lu7did/PixiePico/README.md

# PixiePico
Pixie kit based FT8 transceiver

Project documentation is held at the following [Jupyter notebook file](https://github.com/lu7did/PixiePico/blob/main/doc/PixiePico.ipynb)
