lu7did/PixiePico/doc/PixiePico_API.docx

Generé el proyecto completo testDDS, derivado de testGUI y listo para importar en Visual Studio Code:

Descargar

Incluye:

- src/main.c: integración OLED, encoder, WS2812, USB CDC y DDS.
- src/dds.c y src/dds.h: API, solver exhaustivo, control PLL, DMA y reinicio.
- src/dds_square.pio: generador cuadrado con modulación Bresenham.
- CMakeLists.txt actualizado.
- Configuración .vscode.
- README.md con instrucciones y restricciones.
- tools/verify_solver.py para reproducir los cálculos en una PC.

API implementada:

bool dds_init(dds_t *dds, const dds_config_t *config);

bool dds_solve(const dds_t *dds,

uint32_t target_hz,

dds_solution_t *solution);

bool dds_start(dds_t *dds,

const dds_solution_t *solution);

void dds_stop(dds_t *dds);

dds_setfreq_result_t dds_setfreq(

dds_t *dds,

uint32_t target_hz,

dds_solution_t *solution_out);

Características principales:

- Rango configurable mediante DDS_SYS_CLK_MIN_HZ y DDS_SYS_CLK_MAX_HZ.
- Valores predeterminados: 125–250 MHz.
- Salida predeterminada: GPIO14.
- DDS ubicado en PIO1 para no interferir con el WS2812 de PIO0/SM0.
- State machine y canal DMA reclamados dinámicamente.
- Divisor PIO completo en formato 16.8.
- Patrón Bresenham de 1024 semiperíodos.
- DMA circular de 8192 bytes.
- Solver sin umbral mínimo: siempre devuelve la mejor solución representable, salvo frecuencia cero o fuera del rango físico.
- PLL aplicado antes de stdio_init_all().
- Si dds_setfreq() necesita otro PLL con USB funcionando, guarda la frecuencia y ejecuta un reinicio por watchdog.
- Los scratch registers 6 y 7 evitan interferir con el registro 4 reservado por el SDK.

Resultados reproducidos:

Objetivo | PLL_SYS | CLKDIV PIO | Patrón | Error medio
7.074.000 Hz | 166,5 MHz | 4 + 4/256 | 953/1024 | −0,023339 Hz
14.074.000 Hz | 134 MHz | 2 + 38/256 | 221/1024 | −0,240394 Hz
28.074.000 Hz | 160,5 MHz | 1 + 101/256 | 51/1024 | +0,824722 Hz

El SDK confirma que el divisor PIO tiene formato 16.8 y que check_sys_clock_hz() valida si un reloj es realmente alcanzable; el proyecto usa ambas interfaces directamente. Documentación oficial del Pico SDK (https://www.raspberrypi.com/documentation/pico-sdk/hardware.html)

No pude efectuar la compilación ARM completa porque este entorno no contiene Pico SDK ni pioasm. Sí verifiqué la estructura del proyecto, la integridad del ZIP, las firmas relevantes del SDK y los resultados matemáticos del solver.

Recomendación concreta: importar ahora testDDS en la extensión Raspberry Pi Pico, compilar sin modificar nada y comprobar primero que se genere testDDS.uf2. Después, medir GPIO14 inicialmente a 28,074 MHz y verificar simultáneamente estabilidad USB, frecuencia media y espectro.
