lu7did/PixiePico/doc/Nota Tecnica PLL_PIO_VCO/Nota_Tecnica_Optimizacion_PLL_PIO_RP2040.pdf

## Implementación de VCO usando RP2040

Dr. Pedro E. Colla (LU7DZ) pedro.colla@gmail.com

Proyecto: PixiePico

4 de septiembre de 2026

Resumen

Esta nota técnica documenta el desarrollo de un algoritmo para implementar un VCO (DDS) basado en la utilización de un procesador ARM rp2040 tal como el disponible en placas rp2040 Zero o Raspberry Pico. El VCO utiliza un PIO entre los 8 disponibles en la arquitectura para generar una onda cuadrada a partir del control del clock de ejecución y los divisores disponibles. Se analiza el error obtenible en distintos escenarios y su aplicabilidad en el rango de frecuencias de HF.

## 1. Introducción

Este documento refleja el desarrollo realizado como parte del proyecto PixiePico para implementar un generador de señales que pueda funcionar en el rango de HF a partir de un procesador ARM rp2040. El trabajo se basa en lo desarrollado para el proyecto ADXddsP IO (https://github.com/lu7did/ADX_ddsPIO) antecedentes de técnicas similares se pueden encontrar en el proyecto pico − W SP R − tx (https://github.com/RPiks/pico-WSPR-tx) Se aprovecha la disponibilidad en el procesador ARM rp2040 de hasta 8 procesadores auxiliares RISC denominados PIO, cada uno de ellos con su propio espacio de ejecución y firmware modificable.

## 2. Planteo del problema

El oscilador se construye a partir de una máquina de estados PIO disponible en el procesador rp2040. Esa máquina se configura para utilizar el clock del procesador PLL_SYS (fSY S) como fuente de reloj de la máquina de estados. El programa PIO ejecuta dos estados por cada período de salida: uno mantiene la señal alta y el siguiente la mantiene baja. Por lo tanto, si D es el divisor de reloj de la PIO,

fout =

fSYS
2D
| . | (1)

El divisor utilizado para generar el clock del PIO a partir del clock principal se representa en formato Q16.8:

D = dint +

dfrac
256

=

N
256
, | N = 256dint + dfrac, | (2)

donde 0 ≤ dfrac ≤ 255. Sustituyendo (2) en (1):

fout =

128fSYS
N
. | (3)

## 3. Modelo del PLL del RP2040

Para una referencia externa fXOSC, el PLL genera

fref =

fXOSC
REF DIV
, | (4)
fVCO = frefF BDIV, | (5)

fSYS =

fVCO
P OST DIV 1 P OST DIV 2
| | . | | (6)

La documentación del RP2040 establece las siguientes restricciones del PLL [1]:

| | fref ≥ 5 MHz, | | (7)
750 MHz ≤ fVCO ≤ 1.600 MHz, | (8)
16 ≤ F BDIV ≤ 320, | (9)
1 ≤ P OST DIV 1, P OST DIV 2 ≤ 7. | (10)

Se adopta además P OST DIV 1 ≥ P OST DIV 2, tal como recomienda la documentación. Con fXOSC = 12 MHz, la primera restricción implica

12
REF DIV
≥ 5 | =⇒ | REF DIV ∈ {1, 2} | . | (11)

Por consiguiente se puede fijar REFDIV como parte de la solución mientras genere soluciones válidas.
El intervalo 125 MHz a 250 MHz para fSYS es un requisito experimental del proyecto PixiePico derivado de experimentar con placas rp2040 Zero. El rango superior representa un .overclock"significativo de la placa pues la misma opera en forma nominal a fSY S = 125MHz, sin embargo se comprueba empiricamente que opera bien en esas frecuencias. Algunas placas Raspberry Pico se pueden hacer operar en el intervalo mas amplio 125 MHz a 250 MHz pero esa diferencia no contribuye significativamente a la solución del problema.

## 4. Función objetivo

Combinando (3) y (6) se obtiene

fout =

128fXOSCF BDIV
REF DIV P OST DIV 1 P OST DIV 2 N

(12)

Para una frecuencia objetivo fT , el problema consiste en encontrar la tupla entera

(REF DIV, F BDIV, P OST DIV 1, P OST DIV 2, N) | (13)

que minimiza
E = |fout − fT | , | (14)

sujeta a todas las restricciones anteriores y a

125 MHz ≤ fSYS ≤ 250 MHz. | (15)

No es apropiado optimizar primero el PLL y luego la PIO de manera independiente. Una frecuencia fSYS que no sea la más cercana a un valor elegido a priori puede producir un error final menor al combinarse con cierto valor entero N.

## 5. Algoritmo de búsqueda

El espacio de parámetros es discreto y pequeño. Por ello, una enumeración exhaustiva entrega el óptimo global dentro del modelo.
Para cada cuádrupla válida de parámetros PLL se calcula

N

∗ =

128fSYS
fT
. | (16)

Como el error es monótono a cada lado de N∗

, basta evaluar ⌊N∗

⌋ y ⌈N∗
| ⌉. No es necesario
recorrer los más de dieciséis millones de valores posibles del registro PIO.
Se utiliza aritmética entera, El uso prematuro de aritmética float puede cambiar el orden de candidatos con errores muy próximos.
El código Python que permite evaluar las soluciones para una dada frecuencia objetivo y el error que se puede optimizar es el siguiente:

Listing 1: Implementación de referencia del optimizador

from fractions import Fraction

XOSC = 12_000_000
SYS_MIN = 125_000_000
SYS_MAX = 250_000_000
VCO_MIN = 750_000_000
VCO_MAX = 1_600_000_000

def optimize(target_hz):
best = None

for refdiv in range(1, 64): ref = Fraction(XOSC, refdiv) if ref < 5_000_000:
continue

for fbdiv in range(16, 321):
vco = ref * fbdiv
if not (VCO_MIN <= vco <= VCO_MAX): continue
if ref > vco / 16:
continue

for postdiv1 in range(1, 8):
for postdiv2 in range(1, postdiv1 + 1): sys = vco / (postdiv1 * postdiv2) if not (SYS_MIN <= sys <= SYS_MAX): continue

ideal_n = 128 * sys / target_hz
n0 = ideal_n.numerator // ideal_n.denominator

for n in {n0, n0 + 1}:
if not (256 <= n <= 0xFFFFFF):
continue

actual = 128 * sys / n
signed_error = actual - target_hz

# Mayor VCO como desempate: menor jitter. key = (abs(signed_error), -vco)

candidate = (key, refdiv, fbdiv, postdiv1, postdiv2,
n, vco, sys,
actual, signed_error)

if best is None or key < best[0]: best = candidate

return best

## 6. Resultados

Cuadro 1: Configuraciones óptimas encontradas para frecuencias testigo.
fT (Hz) | REF | FB | PD1 | PD2 | N | fSYS (Hz) | Error (Hz)
7.074.000 | 2 | 263 | 7 | 1 | 4079 | 225.428.571,429 | +2,731762
14.074.000 | 2 | 211 | 3 | 2 | 1919 | 211.000.000,000 | -3,126628
28.074.000 | 2 | 261 | 4 | 3 | 595 | 130.500.000,000 | -50,420168

### 6.1. Caso fT = 7,074 MHz

La mejor tupla es

(REF DIV, F BDIV, P OST DIV 1, P OST DIV 2, N) = (2, 263, 7, 1, 4079) | . | (17)

De ella se obtiene

fref =

12 MHz
2
= 6 MHz, | (18)
fVCO = 6 MHz × 263 = 1.578 MHz, | (19)

fSYS =

1.578 MHz
7
= 225,428.571.428.571 MHz. | (20)

El divisor PIO es
D =

4079
256

= 15 +

239
256
= 15,93359375. | (21)

Finalmente,

fout = 7.074.002,731.762 Hz, | (22)
∆f = | +2,731.762 Hz | , | (23)
ε = | +0,386169 ppm | . | (24)

Como comprobación, 233 MHz también resulta sintetizable cuando se permite REFDIV=2: (2, 233, 3, 2) produce un VCO de 1.398 MHz y fSYS = 233 MHz. Con N = 4216, su error es +3,795.066 Hz, ligeramente mayor que el óptimo global. El error obtenible es compatible con la utilización del generador en FT8 y CW.

### 6.2. Caso fT = 14,074 MHz

La mejor tupla es

(REF DIV, F BDIV, P OST DIV 1, P OST DIV 2, N) = (2, 211, 3, 2, 1919) | . | (25)

Los relojes y el divisor PIO son

fref = 6 MHz, | (26)
fVCO = 1.266 MHz, | (27)

fSYS =

1.266 MHz
6
= 211 MHz, | (28)

D =

1919
256

= 7 +

127
256
= 7,49609375. | (29)

La salida resultante es

fout =

128(211000000)
1919
= 14.073.996,873.372 Hz, | (30)
∆f = | −3,126.628 Hz | , | (31)
ε = | −0,222156 ppm | . | (32)

El error obtenible es compatible con la utilización del generador en FT8 y CW.

### 6.3. Caso fT = 28,074 MHz

Una de las tuplas óptimas es

(REF DIV, F BDIV, P OST DIV 1, P OST DIV 2, N) = (2, 261, 4, 3, 595) | . | (33)

Los valores asociados son

fref = 6 MHz, | (34)
fVCO = 1.566 MHz, | (35)

fSYS =

1.566 MHz
12
= 130,5 MHz, | (36)

D =

595
256

= 2 +

83
256
= 2,32421875. | (37)

La frecuencia obtenida es

fout =

128(130500000)
595
| | = 28.073.949,579.832 Hz, | (38)
∆f = | −50,420.168 Hz | , | (39)
ε = | −1,795974 ppm | . | (40)

Existen varias tuplas con el mismo error para este objetivo. Por ejemplo, el mismo VCO de 1.566 MHz con (P OST DIV 1, P OST DIV 2, N) = (6, 2, 595), (5, 2, 714) o (7, 1, 1020) conserva la misma razón final. La selección entre ellas puede realizarse según frecuencia del sistema, consumo y compatibilidad con el resto del firmware. El error obtenible es compatible con la utilización del generador en CW pero no en FT8.

## 7. Limitaciones

1. La búsqueda obtiene el óptimo global estático dentro de las restricciones establecidas, el error no es cero pero se evalúa dentro de rangos que los hace compatibles con los principales usos anticipados (CW y modos digitales de baja señal).
2. El valor nominal calculado no incluye tolerancia, deriva térmica ni envejecimiento del cristal de 12 MHz. En la práctica, varios ppm del cristal pueden superar el error matemático residual del algoritmo.

3. Una frecuencia racional como 1.578 MHz/7 es físicamente válida. Sin embargo, las API del SDK que almacenan frecuencias en hertz enteros pueden reportarla redondeada. La configuración del PLL debe realizarse a partir de sus parámetros exactos, no reconstruirse desde el entero redondeado.
4. Cambiar PLL_SYS durante la ejecución afecta CPU, PIO y los periféricos derivados de ese reloj. Deben revisarse temporizadores, baud rates, flash y cualquier lógica que suponga una frecuencia fija. El PLL USB es independiente, aunque el firmware USB puede verse afectado indirectamente si el cambio no se secuencia correctamente.
5. Para errores menores que el óptimo estático la solución es alternar entre dos divisores PIO adyacentes en una proporción calculada lo que reduce el error promedio, pero introduce modulación de frecuencia (Jitter) y componentes laterales por lo que se analizará por separado su implementación utilizando un método de acumulación de Bresenham para poder intercalar dos tramas de clocks operando en DMA diferentes.

## 8. Implementación

El firmware debe conservar los cinco parámetros de la solución óptima, no solo fSYS y
D. La estructura de resultado debe incluir como mínimo refdiv, fbdiv, postdiv1, postdiv2, pio_div_int, pio_div_frac, frecuencia calculada y error. Antes de aplicar el resultado, debe verificarse nuevamente cada restricción y configurar el PLL mediante sus parámetros exactos. El diseño es adecuado para modos digitales de baja señal en bandas de HF hasta 14 MHz y hasta 28 MHz para CW.

## Referencias

[1] Raspberry Pi Ltd., RP2040 Datasheet: A microcontroller by Raspberry Pi, sección 2.18, “PLL”, versión de febrero de 2025. Disponible en: https://datasheets.raspberrypi.com/rp2040/rp2040-datasheet.pdf. (https://datasheets.raspberrypi.com/rp2040/rp2040-datasheet.pdf)
[2] Raspberry Pi Ltd., Pico SDK—hardware_pll, implementación de pll_init. Disponible en: https://github.com/raspberrypi/pico-sdk/blob/master/src/rp2_common/hardware_pll/pll.c. (https://github.com/raspberrypi/pico-sdk/blob/master/src/rp2_common/hardware_pll/pll.c)
[3] Transceiver digital modos de señales débiles https://github.com/lu7did/ADX_ddsPIO.
[4] Transmisor | digital | usando | VCO | basado | en | rp2040 | https://github.com/RPiks/
pico-WSPR-tx. (https://github.com/RPiks/pico-WSPR-tx)
