lu7did/PixiePico/doc/CCLicense.png

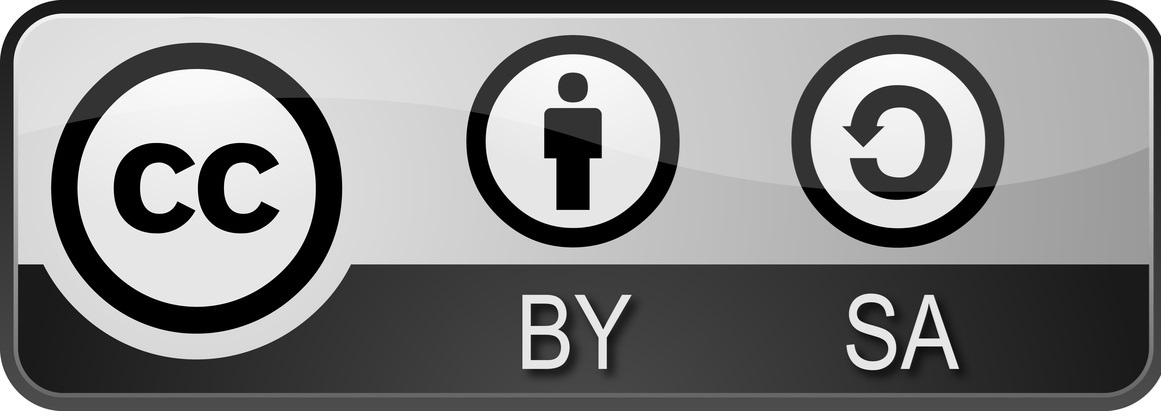
doc/CCLicense.png
