lu7did/PixiePico/doc/Draft1.png

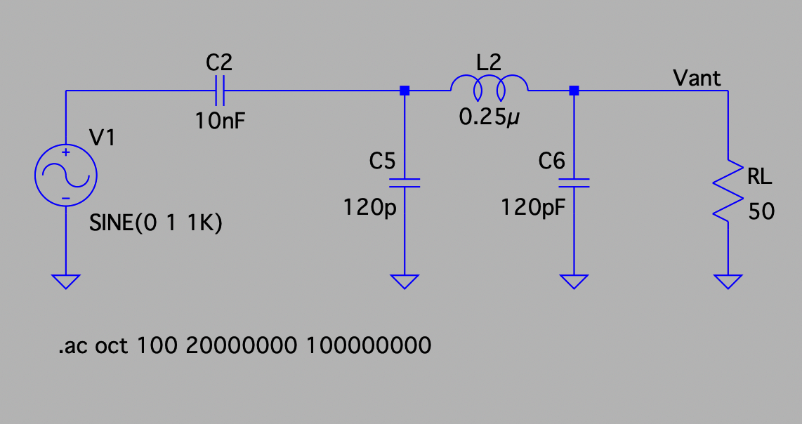
doc/Draft1.png
