lu7did/PixiePico/doc/LTSpice_PixiePico_TX_7MHz_FFT.png

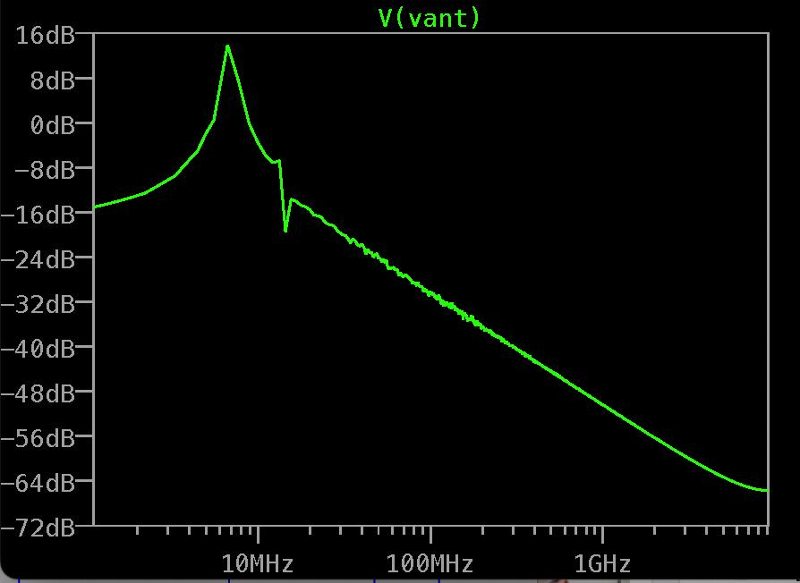
doc/LTSpice_PixiePico_TX_7MHz_FFT.png
