lu7did/PixiePico/doc/lupin.jpg

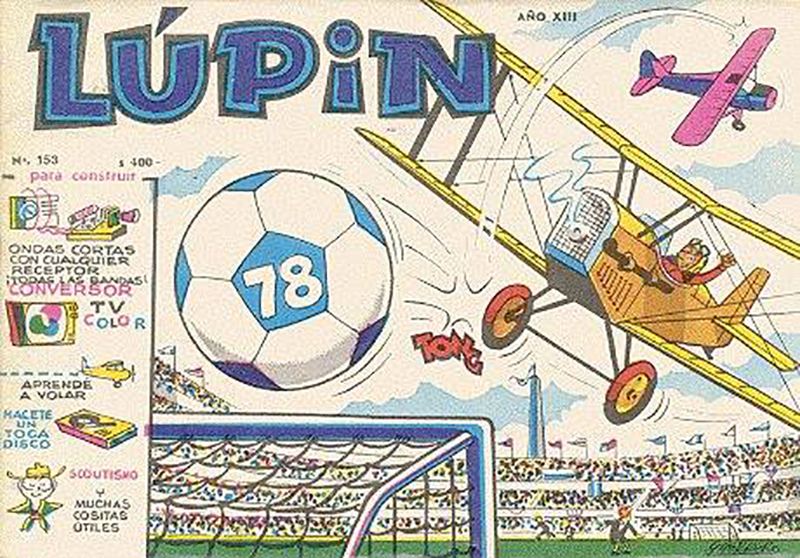
doc/lupin.jpg
