lu7did/PixiePico/doc/PixiePico.png

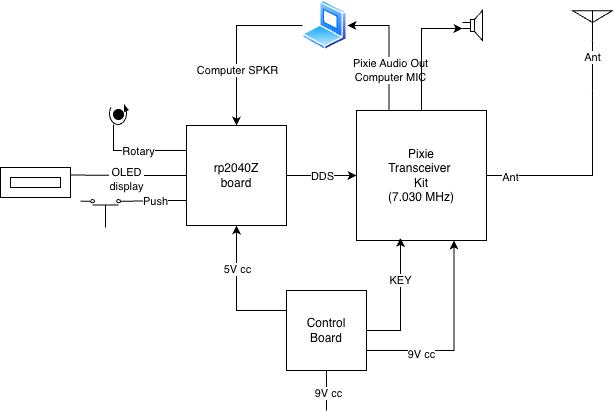
doc/PixiePico.png
