lu7did/PixiePico/doc/PixiePico_AFFilter.png

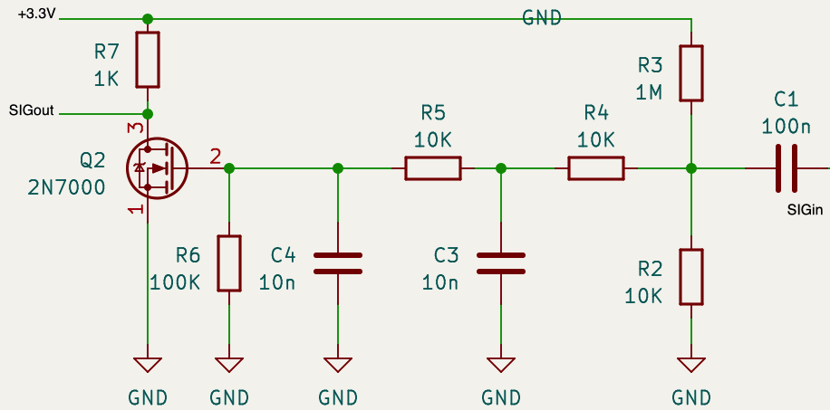
doc/PixiePico_AFFilter.png
