lu7did/PixiePico/doc/PixiePico_Architecture.png

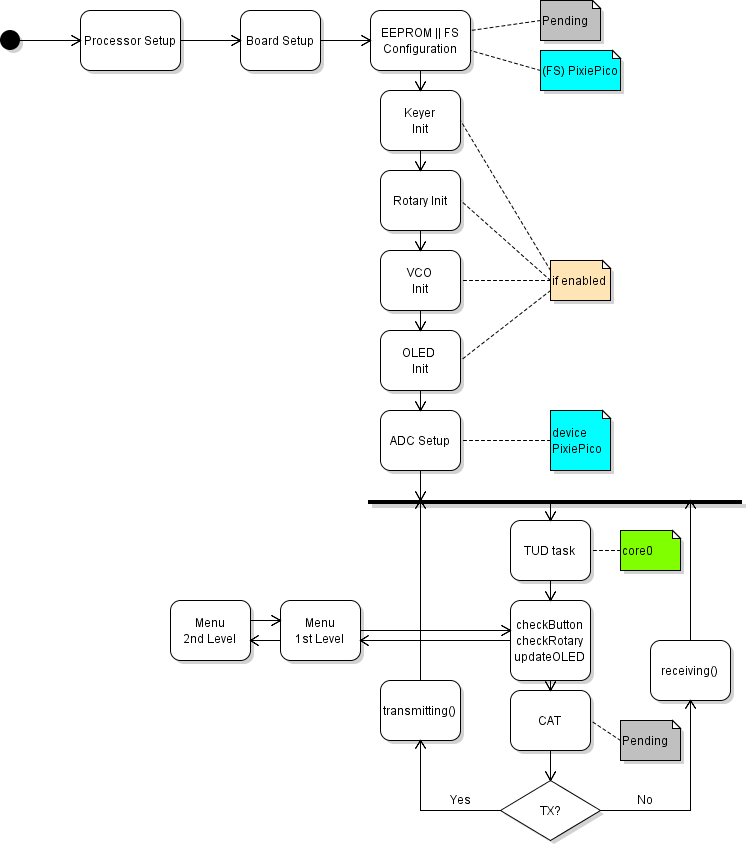
doc/PixiePico_Architecture.png
