lu7did/PixiePico/doc/PixiePico_LTSpice_AFFilter_Circuit.png

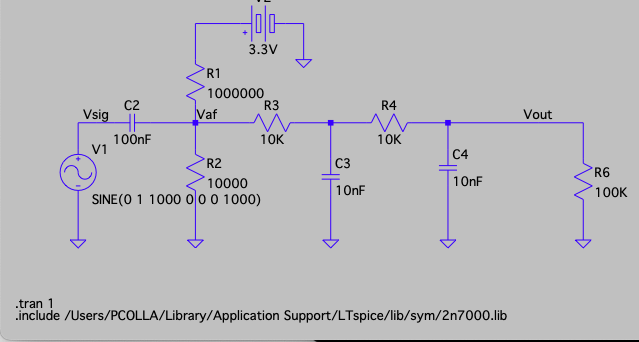
doc/PixiePico_LTSpice_AFFilter_Circuit.png
