lu7did/PixiePico/doc/PixiePico_LTSpice_AFFilter_FreqAnalysis.png

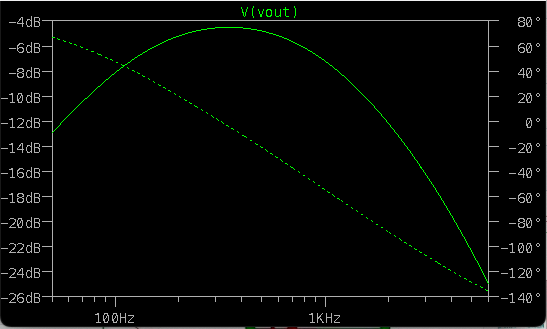
doc/PixiePico_LTSpice_AFFilter_FreqAnalysis.png
