lu7did/PixiePico/doc/PixiePico_LTSpice_AFFilter_SignalAnalysis.png

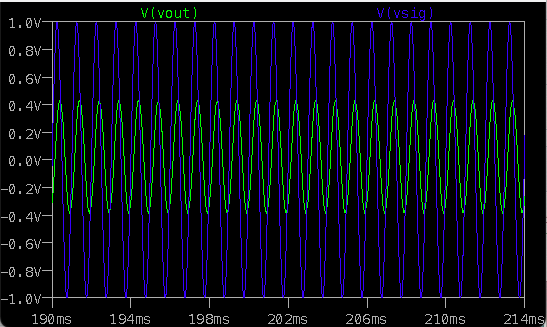
doc/PixiePico_LTSpice_AFFilter_SignalAnalysis.png
