lu7did/PixiePico/doc/PixiePico_LTSpice_AFFilterLimiter_Circuit.png

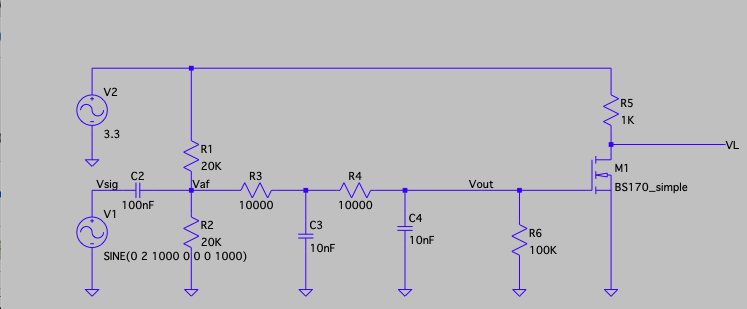
doc/PixiePico_LTSpice_AFFilterLimiter_Circuit.png
