lu7did/PixiePico/doc/PixiePico_LTSpice_AFFilterLimiter_SignalAnalysis.png

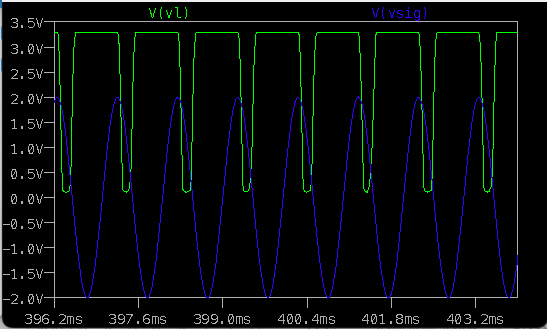
doc/PixiePico_LTSpice_AFFilterLimiter_SignalAnalysis.png
