lu7did/PixiePico/doc/PixiePico_LTSpice_RX_Circuit.png

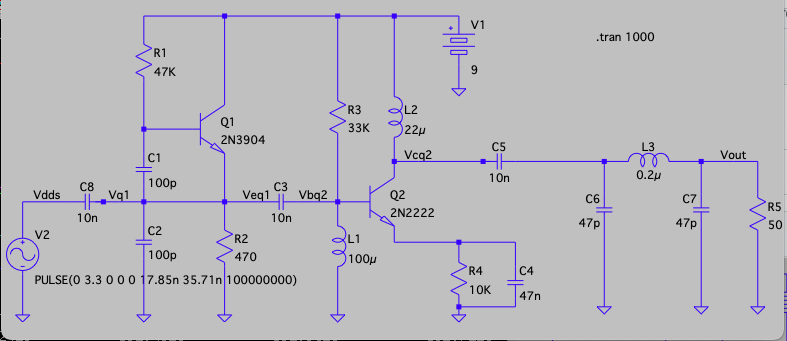
doc/PixiePico_LTSpice_RX_Circuit.png
