lu7did/PixiePico/doc/PixiePico_LTSpice_RX_SignalAnalysis.png

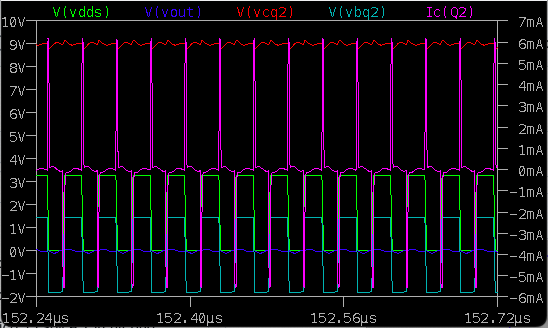
doc/PixiePico_LTSpice_RX_SignalAnalysis.png
