lu7did/PixiePico/doc/PixiePico_LTSpice_TX_Circuit.png

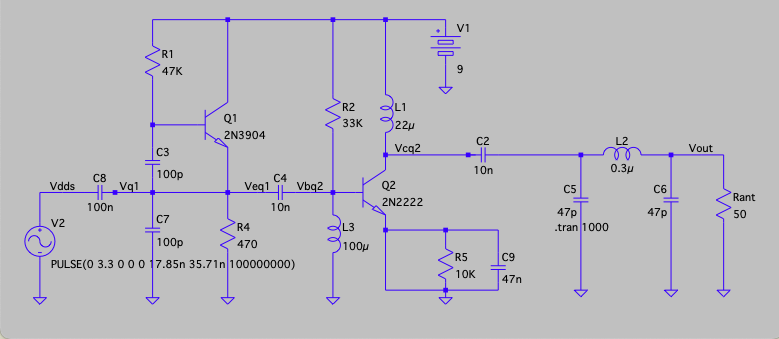
doc/PixiePico_LTSpice_TX_Circuit.png
