lu7did/PixiePico/doc/PixiePico_LTSpice_TX_FFT.png

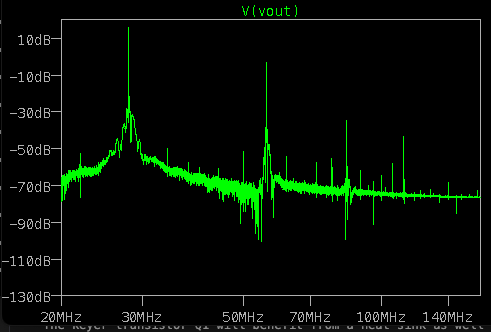
doc/PixiePico_LTSpice_TX_FFT.png
