lu7did/PixiePico/doc/PixiePico_LTSpice_TX_SignalAnalysis.png

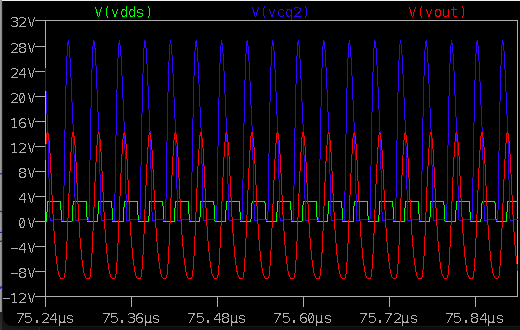
doc/PixiePico_LTSpice_TX_SignalAnalysis.png
