lu7did/PixiePico/doc/PixiePico_RF.png

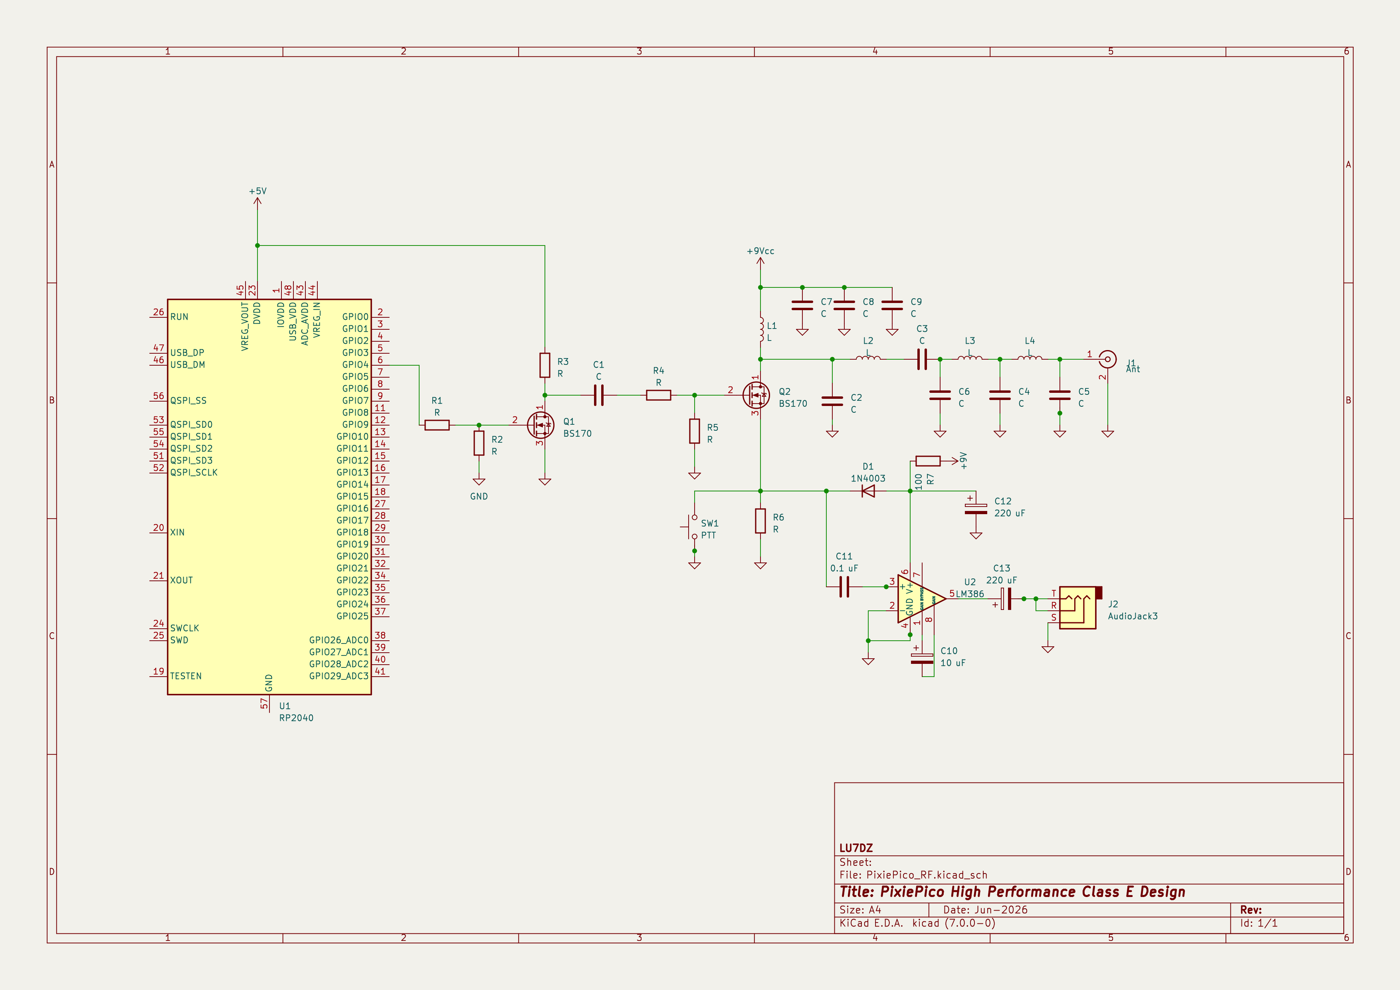
doc/PixiePico_RF.png
