lu7did/PixiePico/doc/PixiePico_TRX_activity.png

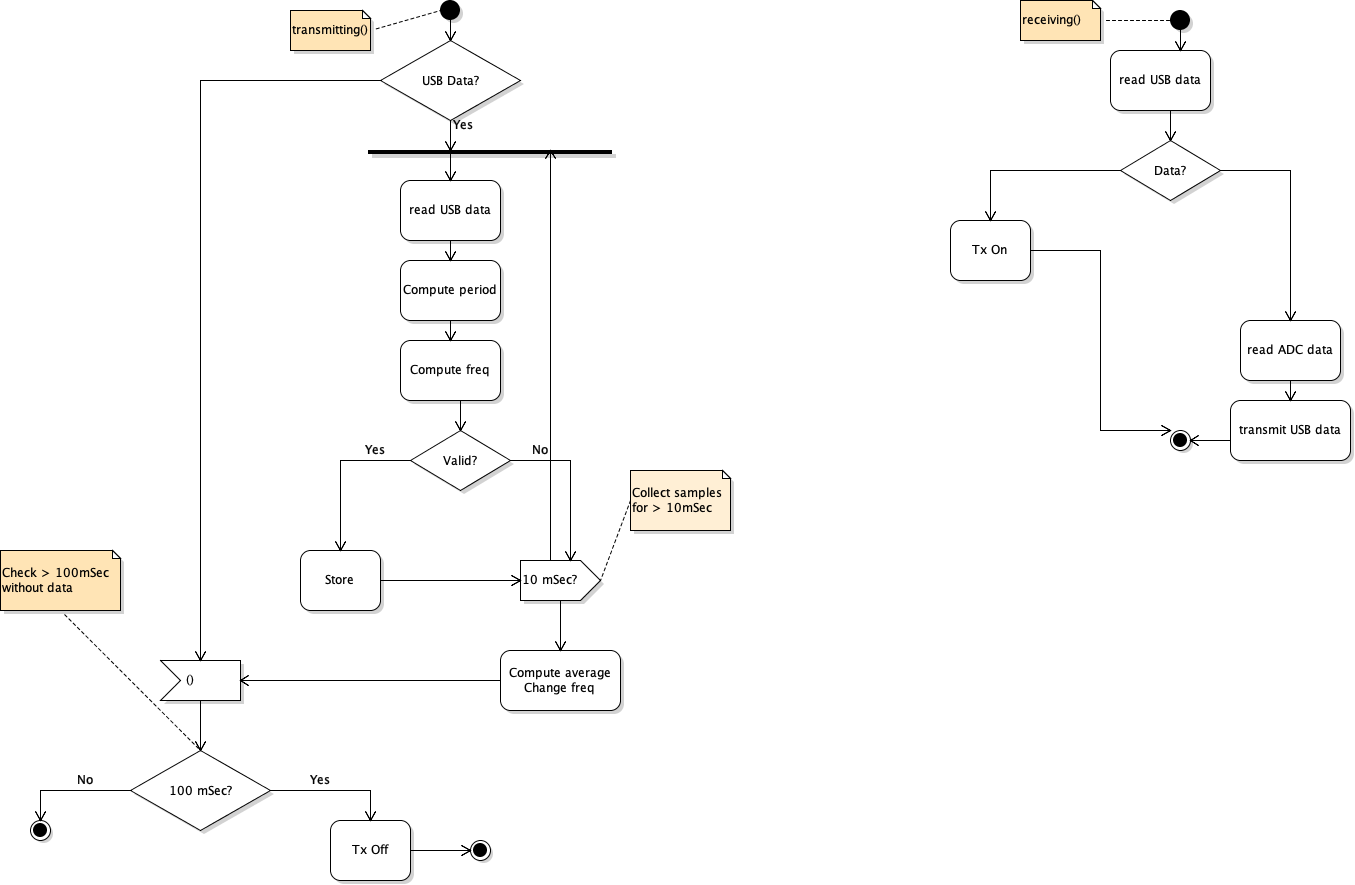
doc/PixiePico_TRX_activity.png
