lu7did/PixiePico/doc/vco.png

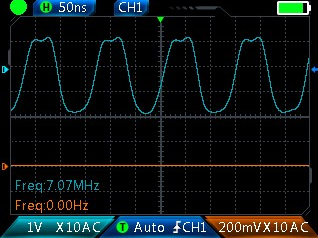
doc/vco.png
