lu7did/PixiePico/PixiePico_LTSpice_PiFilter_Response.png

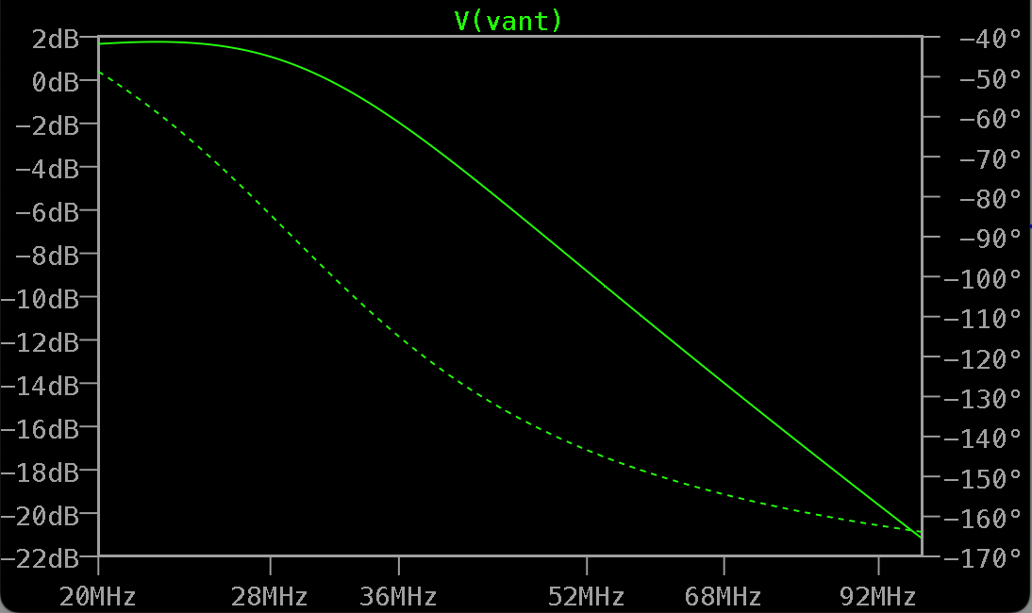
PixiePico_LTSpice_PiFilter_Response.png
