lu7did/PixiePico/PixiePico_RF/CCLicense.png

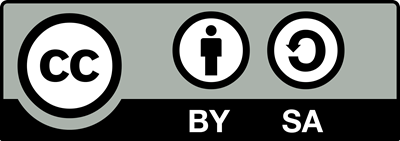
PixiePico_RF/CCLicense.png
