lu7did/PixiePico/doc/LTSpice_PixiePico_TX_Design.asc

C2: Cap; 100n
C3: cap; 100p
C4: Cap; 100n
C5: Cap; 470p
C6: Cap; 470p
C7: cap; 100p
Cx: Cap; 100n
L1: ind; 22µ
L2: ind; 1µ
L3: ind; 100µ
Q1: npn; 2N3904
Q2: npn; 2N3904
R1: Res; 47K
R2: Res; 33K
R4: Res; 1000
Rant: Res; 50
V1: battery; 9
V2: signal; PULSE(0 3.3 0 0 0 0.000000071428571 0.000000142857143)
Named nets: 0, Vant, Vgen, Vosc, VCQ2, VEQ1
.tran 1
