lu7did/PixiePico/doc/LTSpice_PiFilter_Design.asc

C1: cap; 47p
C2: cap; 47p
C3: cap; 10n
L1: ind; 0.3µ
R1: res; 50
V1: signal; SINE(0 1 28000000 0 0 0 10000); AC 1
Named nets: 0, Vout
.ac oct 1000 20000000 100000000
