lu7did/PixiePico/doc/Draft1.asc

C2: cap; 10nF
C5: cap; 120p
C6: cap; 120pF
L2: Ind; 0.25µ
RL: Res; 50
V1: signal; AC 1 0
Named nets: 0, Vant
.ac oct 100 20000000 100000000
