lu7did/PixiePico/doc/PixiePico_LTSpice_AFFilter.asc

C2: cap; 100nF
C3: cap; 10nF
C4: cap; 10nF
M1: nmos; BS170_simple
R1: Res; 20K
R2: Res; 20K
R3: Res; 10000
R4: Res; 10000
R5: Res; 1K
R6: res; 100K
V1: signal; SINE(0 2 1000 0 0 0 1000); AC 1
V2: signal; 3.3; AC 3.3
Named nets: 0, Vsig, Vaf, Vout, VL
.tran 1
.model BS170_simple VDMOS VTO=1.824 RG=270 RS=1.572 RD=1.436 RB=.768 KP=.1233 Cgdmax=7p Cgdmin=3p CGS=28p Cjo=35p Rds=1.2E8 IS=5p RS=.768
