lu7did/PixiePico/PixiePico_RF/PixiePico_RF.kicad_pcb

## KiCad design diagrams/IDP.kicad_sch

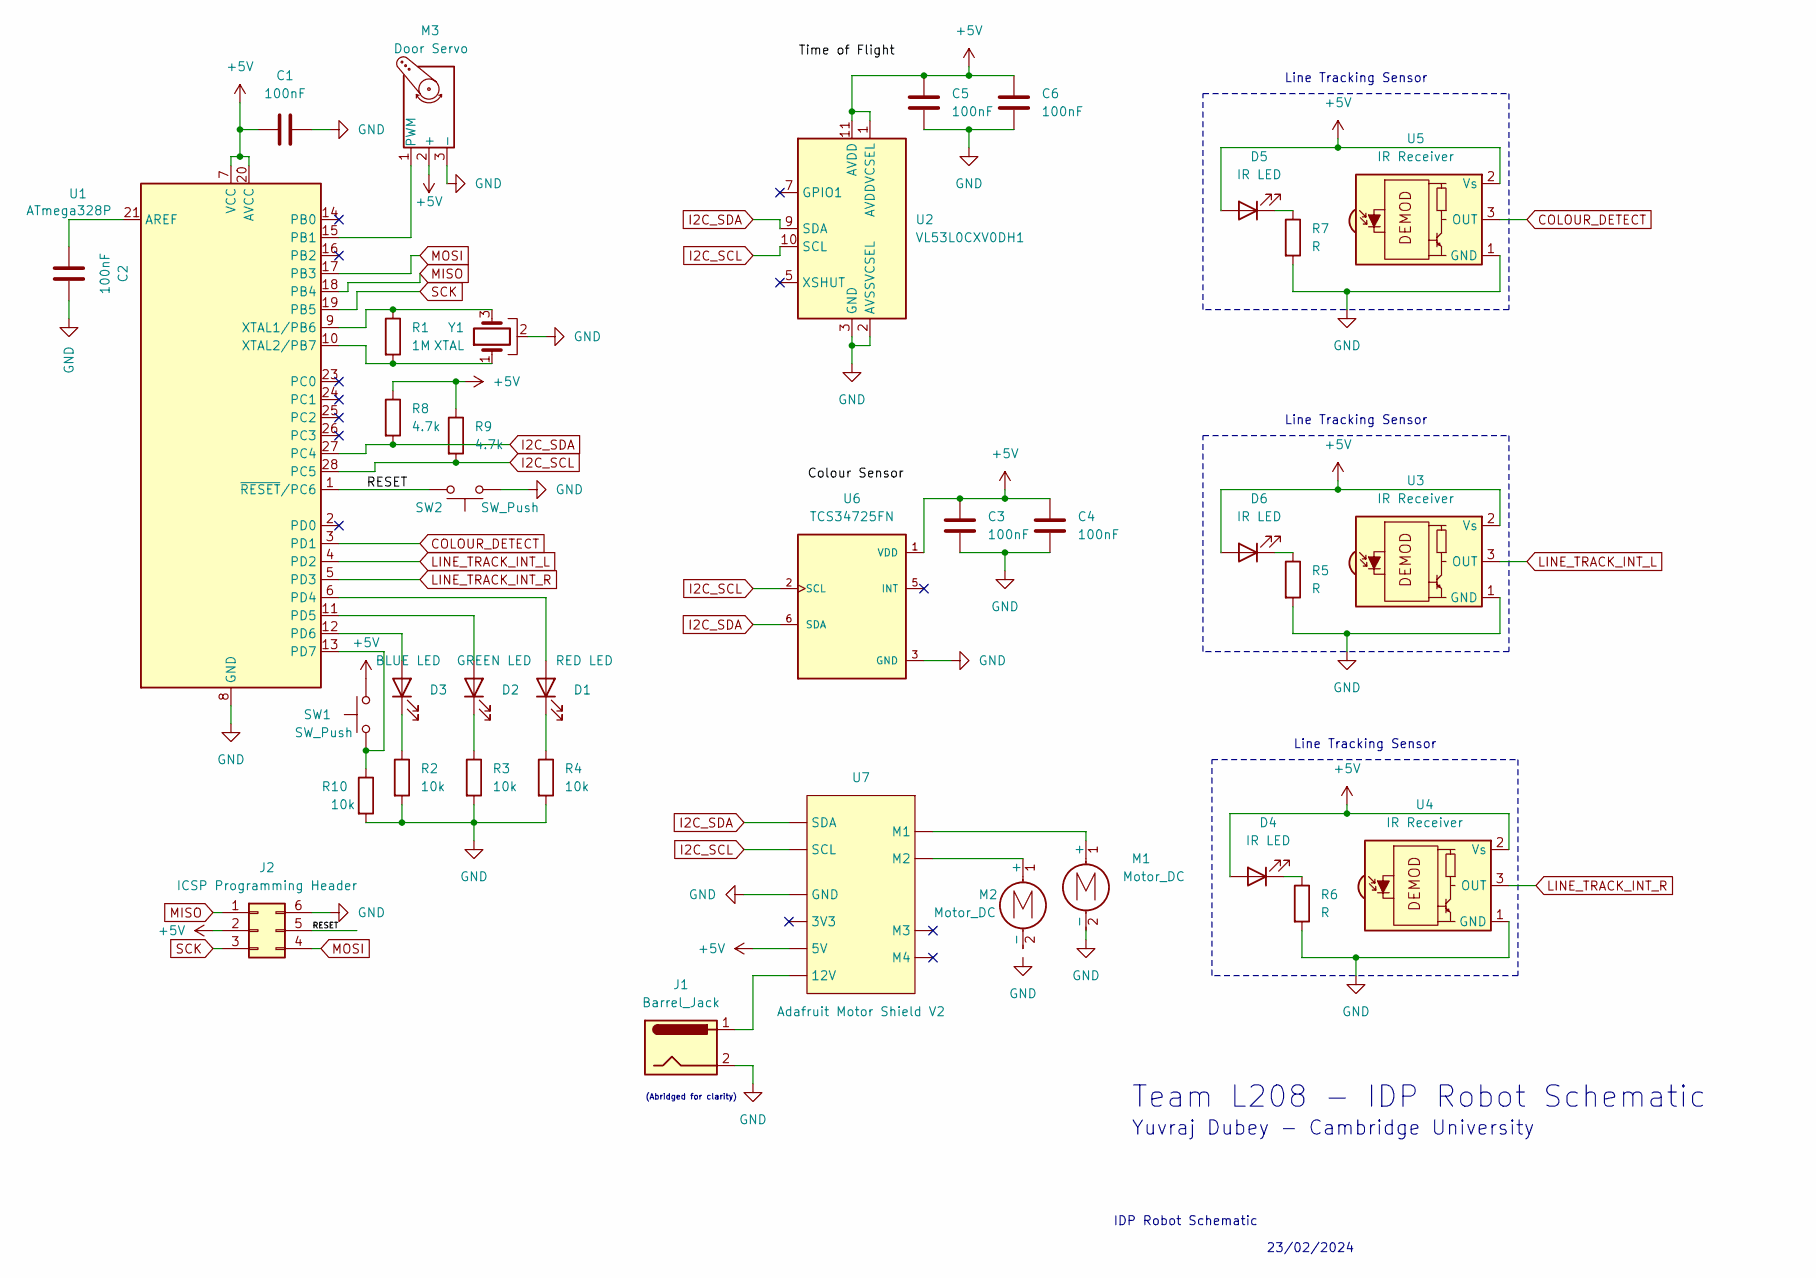
[picture p45: schematic IDP.kicad_sch]

Parts:
C1, C2, C3, C4, C5, C6: 100nF
D1: RED LED
D2: GREEN LED
D3: BLUE LED
D4, D5, D6: IR LED
J1: Barrel_Jack
J2: ICSP Programming Header
M1, M2: Motor_DC
M3: Door Servo
R1: 1M
R2, R3, R4, R10: 10k
R5, R6, R7: R
R8, R9: 4.7k
SW1, SW2: SW_Push
U1: ATmega328P; DIP-28_W7.62mm
U2: VL53L0CXV0DH1; ST_VL53L1x
U3, U4, U5: IR Receiver; Vishay_CAST-3Pin
U6: TCS34725FN; SON65P200X240X70-6N; PARTREV 1-02
U7: Adafruit Motor Shield V2
Y1: XTAL

Connections:
+5V: C1.1, C3.1, C4.2, C5.1, C6.2, D4.2 (A), D5.2 (A), D6.2 (A), J2.2, M3.2 (+), R8.1, R9.1, SW1.2, U1.7 (VCC), U1.20 (AVCC), U2.1 (AVDDVCSEL), U2.11 (AVDD), U3.2 (Vs), U4.2 (Vs), U5.2 (Vs), U6.1 (VDD), U7.
COLOUR_DETECT: U1.3 (PD1), U5.3 (OUT)
GND: C1.2, C2.2, C3.2, C4.1, C5.2, C6.1, J1.2, J2.6, M1.2 (-), M3.3 (-), R2.2, R3.2, R4.2, R5.2, R6.2, R7.2, R10.2, SW2.1, U1.8 (GND), U1.22 (GND), U2.2 (AVSSVCSEL), U2.3 (GND), U2.4 (GND), U2.6 (GND), U2.12 (GND), U3.1 (GND), U4.1 (GND), U5.1 (GND), U6.3 (GND), U7., Y1.2
I2C_SCL: R9.2, U1.28 (PC5), U2.10 (SCL), U6.2 (SCL), U7.
I2C_SDA: R8.2, U1.27 (PC4), U2.9 (SDA), U6.6 (SDA), U7.
LINE_TRACK_INT_L: U1.4 (PD2), U3.3 (OUT)
LINE_TRACK_INT_R: U1.5 (PD3), U4.3 (OUT)
MISO: J2.1, U1.18 (PB4)
MOSI: J2.4, U1.17 (PB3)
unnamed: C2.1, U1.21 (AREF)
unnamed: D1.1 (K), R4.1
unnamed: D1.2 (A), U1.6 (PD4)
unnamed: D2.1 (K), R3.1
unnamed: D2.2 (A), U1.11 (PD5)
unnamed: D3.1 (K), R2.1
unnamed: D3.2 (A), U1.12 (PD6)
unnamed: D4.1 (K), R6.1
unnamed: D5.1 (K), R7.1
unnamed: D6.1 (K), R5.1
unnamed: J1.1, U7.
unnamed: M1.1 (+), U7.
unnamed: M2.1 (+), U7.
unnamed: M3.1 (PWM), U1.15 (PB1)
unnamed: R1.1, U1.9 (XTAL1/PB6), Y1.3
unnamed: R1.2, U1.10 (XTAL2/PB7), Y1.1
unnamed: R10.1, SW1.1, U1.13 (PD7)
RESET: J2.5, SW2.2, U1.1 (~RESET/PC6)
SCK: J2.3, U1.19 (PB5)

Notes on the sheet:
23/02/2024
Line Tracking Sensor
(Abridged for clarity)
Team L208 - IDP Robot Schematic
IDP Robot Schematic
Yuvraj Dubey - Cambridge University
