lu7did/PixiePico/src/PixiePico_CDC_only/PixiePico/src/fat12_64k.h

/*
 * =======================================================================================
 * fast12_64k
 * (c) Dr. Pedro E. Colla (LU7DZ) <pedro.colla@gmail.com>
 * 
 * This is the empty image of a FAT12 64K disk used to format the filesystem
 * implementing a file called ADXDISK 
 * =======================================================================================*/

unsigned char fat12_64k_img[] = {
  0xeb, 0x3c, 0x90, 0x42, 0x53, 0x44, 0x20, 0x20, 0x34, 0x2e, 0x34, 0x00,
  0x02, 0x01, 0x01, 0x00, 0x02, 0x00, 0x02, 0x80, 0x00, 0xf0, 0x01, 0x00,
  0x20, 0x00, 0x10, 0x00, 0x00, 0x00, 0x00, 0x00, 0x00, 0x00, 0x00, 0x00,
  0x00, 0x00, 0x29, 0x10, 0x1c, 0x3e, 0x25, 0x41, 0x44, 0x58, 0x44, 0x49,
  0x53, 0x4b, 0x20, 0x20, 0x20, 0x20, 0x46, 0x41, 0x54, 0x31, 0x32, 0x20,
  0x20, 0x20, 0xfa, 0x31, 0xc0, 0x8e, 0xd0, 0xbc, 0x00, 0x7c, 0xfb, 0x8e,
  0xd8, 0xe8, 0x00, 0x00, 0x5e, 0x83, 0xc6, 0x19, 0xbb, 0x07, 0x00, 0xfc,
  0xac, 0x84, 0xc0, 0x74, 0x06, 0xb4, 0x0e, 0xcd, 0x10, 0xeb, 0xf5, 0x30,
  0xe4, 0xcd, 0x16, 0xcd, 0x19, 0x0d, 0x0a, 0x4e, 0x6f, 0x6e, 0x2d, 0x73,
  0x79, 0x73, 0x74, 0x65, 0x6d, 0x20, 0x64, 0x69, 0x73, 0x6b, 0x0d, 0x0a,
  0x50, 0x72, 0x65, 0x73, 0x73, 0x20, 0x61, 0x6e, 0x79, 0x20, 0x6b, 0x65,
  0x79, 0x20, 0x74, 0x6f, 0x20, 0x72, 0x65, 0x62, 0x6f, 0x6f, 0x74, 0x0d,
  0x0a, 0x00, 0x00, 0x00, 0x00, 0x00, 0x00, 0x00, 0x00, 0x00, 0x00, 0x00,
  0x00, 0x00, 0x00, 0x00, 0x00, 0x00, 0x00, 0x00, 0x00, 0x00, 0x00, 0x00,
  0x00, 0x00, 0x00, 0x00, 0x00, 0x00, 0x00, 0x00, 0x00, 0x00, 0x00, 0x00,
  0x00, 0x00, 0x00, 0x00, 0x00, 0x00, 0x00, 0x00, 0x00, 0x00, 0x00, 0x00,
  0x00, 0x00, 0x00, 0x00, 0x00, 0x00, 0x00, 0x00, 0x00, 0x00, 0x00, 0x00,
  0x00, 0x00, 0x00, 0x00, 0x00, 0x00, 0x00, 0x00, 0x00, 0x00, 0x00, 0x00,
  0x00, 0x00, 0x00, 0x00, 0x00, 0x00, 0x00, 0x00, 0x00, 0x00, 0x00, 0x00,
  0x00, 0x00, 0x00, 0x00, 0x00, 0x00, 0x00, 0x00, 0x00, 0x00, 0x00, 0x00,
  0x00, 0x00, 0x00, 0x00, 0x00, 0x00, 0x00, 0x00, 0x00, 0x00, 0x00, 0x00,
  0x00, 0x00, 0x00, 0x00, 0x00, 0x00, 0x00, 0x00, 0x00, 0x00, 0x00, 0x00,
  0x00, 0x00, 0x00, 0x00, 0x00, 0x00, 0x00, 0x00, 0x00, 0x00, 0x00, 0x00,
  0x00, 0x00, 0x00, 0x00, 0x00, 0x00, 0x00, 0x00, 0x00, 0x00, 0x00, 0x00,
  0x00, 0x00, 0x00, 0x00, 0x00, 0x00, 0x00, 0x00, 0x00, 0x00, 0x00, 0x00,
  0x00, 0x00, 0x00, 0x00, 0x00, 0x00, 0x00, 0x00, 0x00, 0x00, 0x00, 0x00,
  0x00, 0x00, 0x00, 0x00, 0x00, 0x00, 0x00, 0x00, 0x00, 0x00, 0x00, 0x00,
  0x00, 0x00, 0x00, 0x00, 0x00, 0x00, 0x00, 0x00, 0x00, 0x00, 0x00, 0x00,
  0x00, 0x00, 0x00, 0x00, 0x00, 0x00, 0x00, 0x00, 0x00, 0x00, 0x00, 0x00,
  0x00, 0x00, 0x00, 0x00, 0x00, 0x00, 0x00, 0x00, 0x00, 0x00, 0x00, 0x00,
  0x00, 0x00, 0x00, 0x00, 0x00, 0x00, 0x00, 0x00, 0x00, 0x00, 0x00, 0x00,
  0x00, 0x00, 0x00, 0x00, 0x00, 0x00, 0x00, 0x00, 0x00, 0x00, 0x00, 0x00,
  0x00, 0x00, 0x00, 0x00, 0x00, 0x00, 0x00, 0x00, 0x00, 0x00, 0x00, 0x00,
  0x00, 0x00, 0x00, 0x00, 0x00, 0x00, 0x00, 0x00, 0x00, 0x00, 0x00, 0x00,
  0x00, 0x00, 0x00, 0x00, 0x00, 0x00, 0x00, 0x00, 0x00, 0x00, 0x00, 0x00,
  0x00, 0x00, 0x00, 0x00, 0x00, 0x00, 0x00, 0x00, 0x00, 0x00, 0x00, 0x00,
  0x00, 0x00, 0x00, 0x00, 0x00, 0x00, 0x00, 0x00, 0x00, 0x00, 0x00, 0x00,
  0x00, 0x00, 0x00, 0x00, 0x00, 0x00, 0x00, 0x00, 0x00, 0x00, 0x00, 0x00,
  0x00, 0x00, 0x00, 0x00, 0x00, 0x00, 0x00, 0x00, 0x00, 0x00, 0x00, 0x00,
  0x00, 0x00, 0x00, 0x00, 0x00, 0x00, 0x00, 0x00, 0x00, 0x00, 0x00, 0x00,
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
};
unsigned int fat12_64k_img_len = 65536;
