lu7did/PixiePico/src/testDDS/src/rotary_encoder.h

#ifndef TESTGUI_ROTARY_ENCODER_H
#define TESTGUI_ROTARY_ENCODER_H

#include <stdbool.h>
#include "pico/types.h"

typedef struct {
    uint pin_a;
    uint pin_b;
    uint pin_sw;
    bool raw_pressed;
    bool stable_pressed;
    absolute_time_t raw_changed_at;
} rotary_encoder_t;

void rotary_encoder_init(rotary_encoder_t *encoder,
                         uint pin_a, uint pin_b, uint pin_sw);
int rotary_encoder_take_steps(void);
bool rotary_encoder_poll_switch(rotary_encoder_t *encoder, bool *pressed);

#endif
