lu7did/PixiePico/(commit log)

2026-05-15 resume project
    [PixiePico_Pin_Assignment.xlsx]
2026-09-06 Clean up V1.0
    [PixiePico_Pin_Assignment.xlsx]
