lu7did/PixiePico/(notices)

Notices in the files:
src/PixiePico/src/main.c:
This program is free software: you can redistribute it and/or modify
it under the terms of the CC BY-AS License.
